Luddi1/LoRaWAN-fence-monitor/README.md

# LoRaWAN electric fence monitor

Based on STM32L071KBT and RFM95 monitors an electric fence and sends out warning if voltage too low or not present. BOM is about 20€.
