Luddi1/LoRaWAN-fence-monitor/lora_fence_monitor_hardware/Schematic.pdf

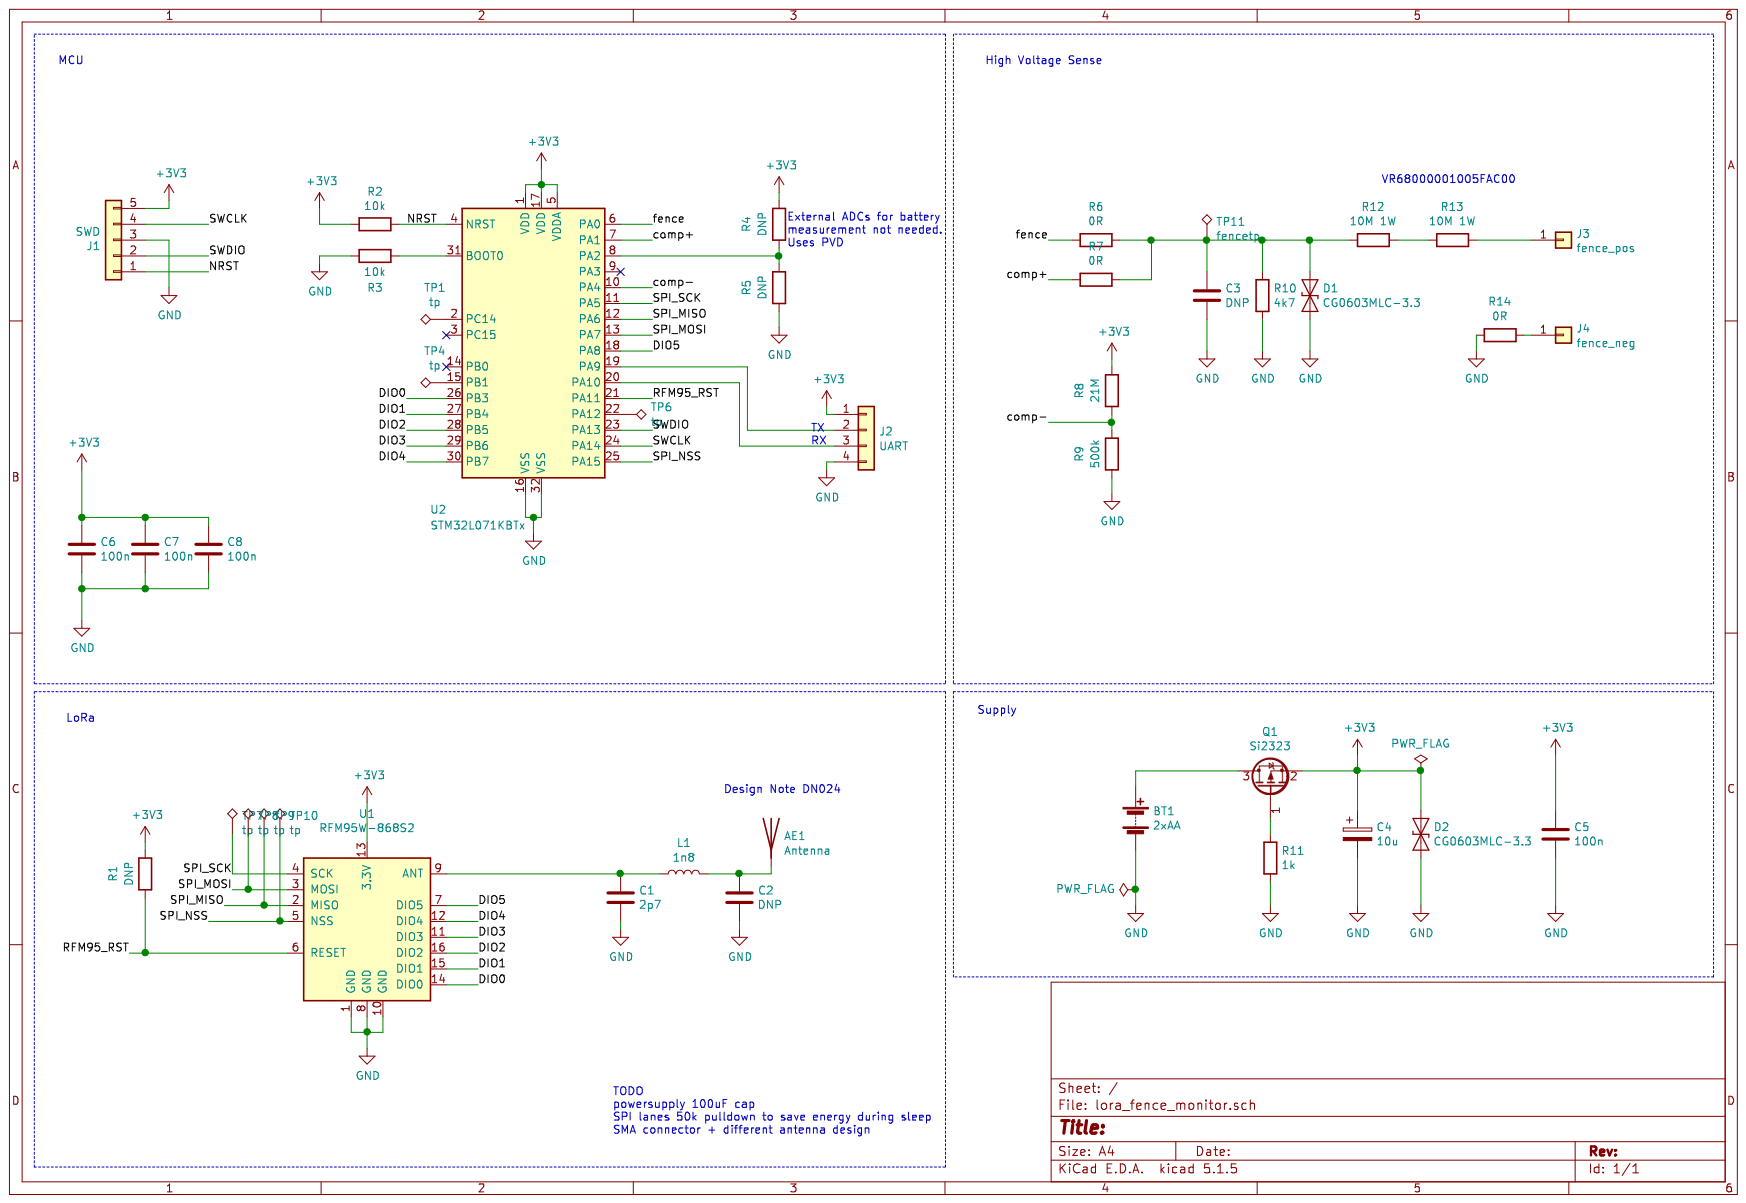
[picture p2: page 1]
