Luddi1/LoRaWAN-fence-monitor/lora_fence_monitor_hardware/lora_fence_monitor.kicad_pcb

## KiCad design lora_fence_monitor_hardware/lora_fence_monitor.kicad_pcb (2020-03-31)

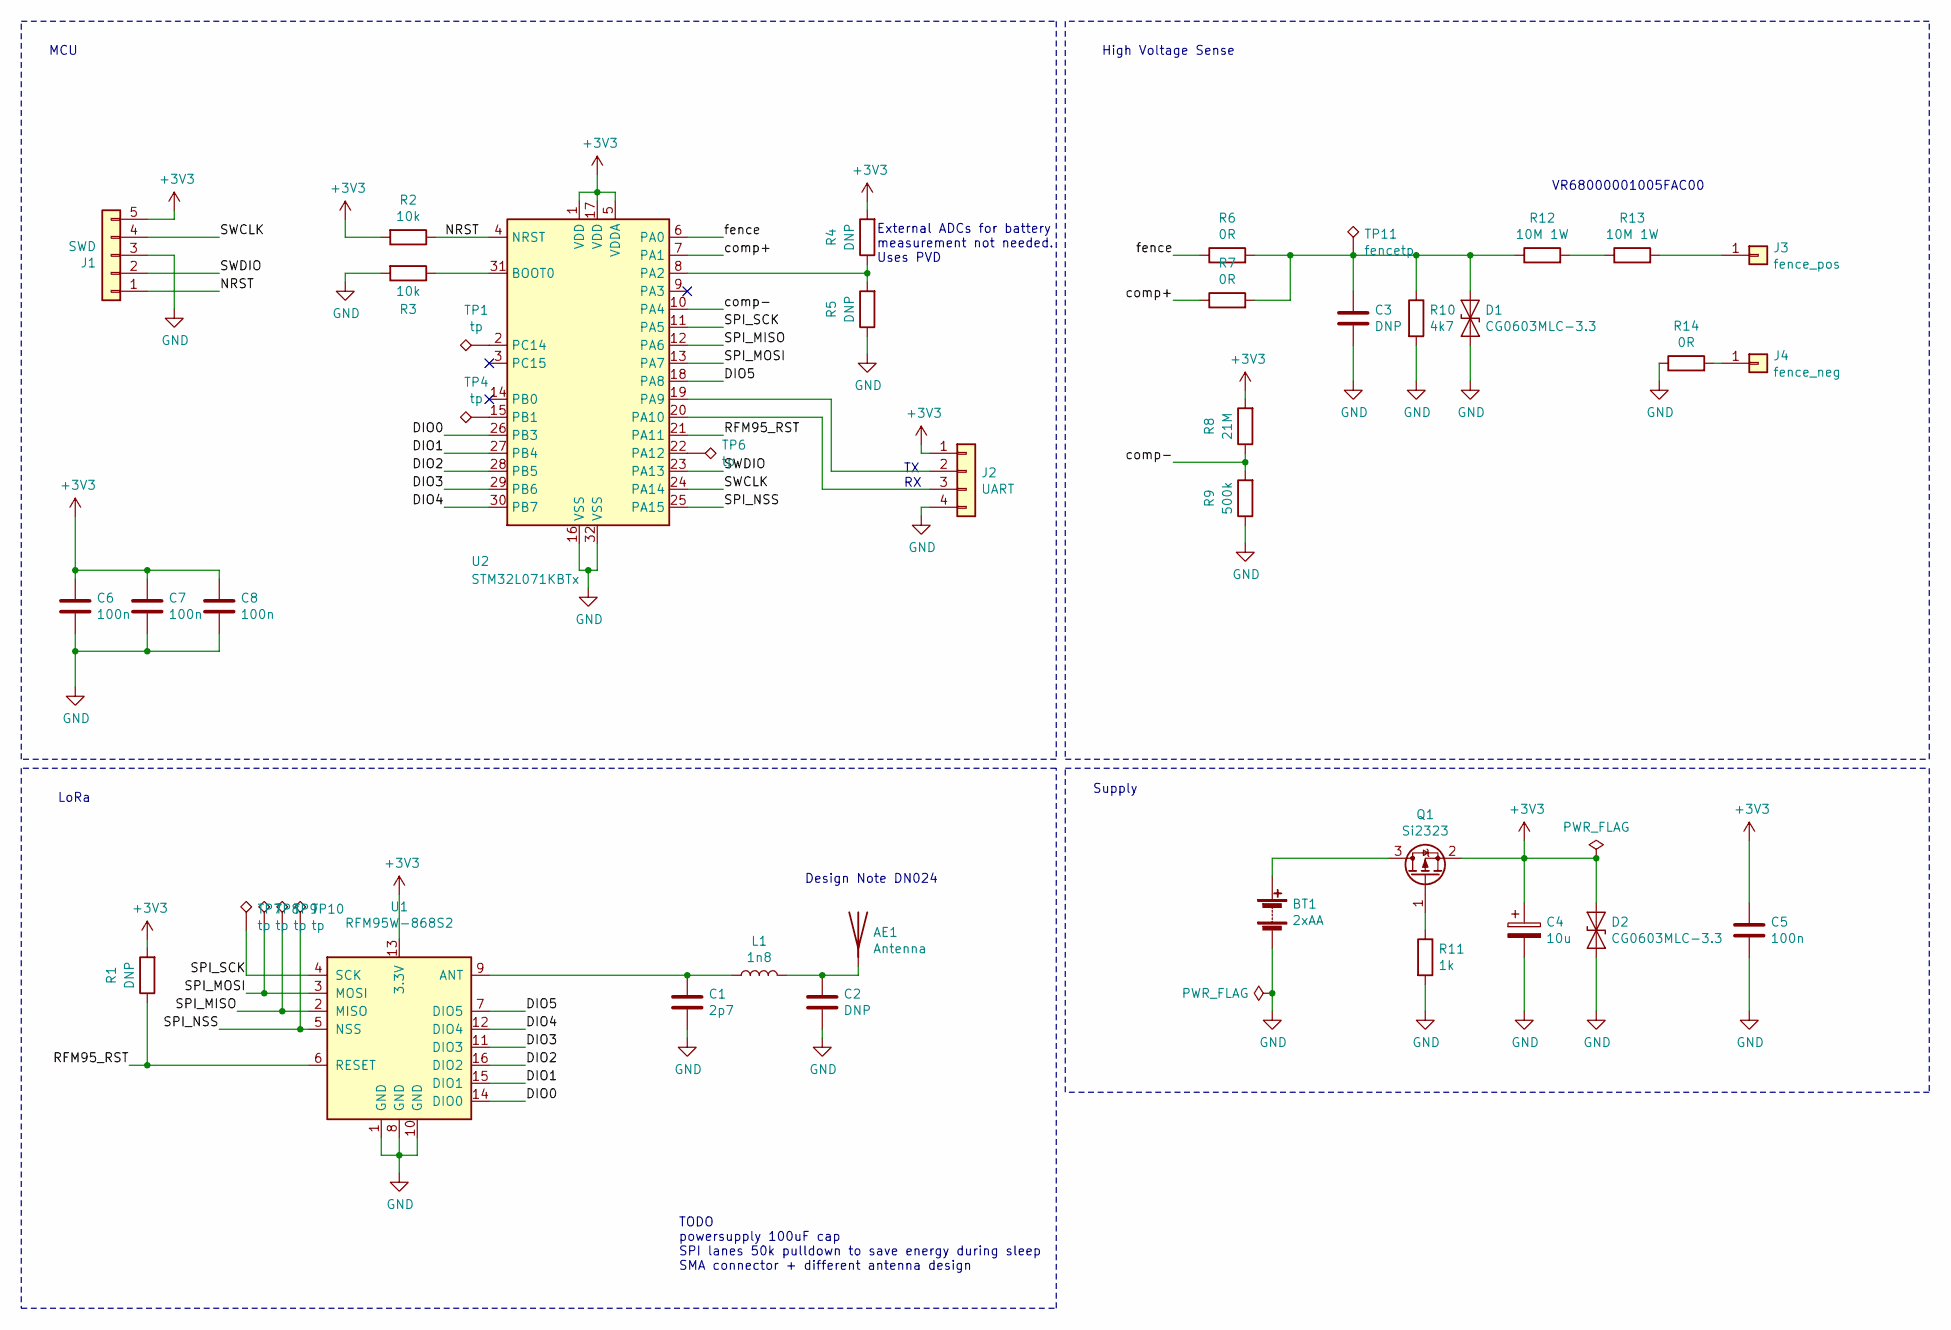
[picture p3: schematic lora_fence_monitor.sch]

Parts:
AE1: Antenna; Texas_SWRA227E_868MHz
BT1: 2xAA; BatteryHolder_Keystone_2462_2xAA
C1: 2p7; C_0402_1005Metric
C2: DNP; C_0402_1005Metric
C3: DNP; C_0805_2012Metric
C4: 10u; C_0805_2012Metric
C5, C6, C7, C8: 100n; C_0805_2012Metric
D1, D2: CG0603MLC-3.3; D_0603_1608Metric
J1: SWD; PinHeader_1x05_P2.54mm_Vertical
J2: UART; PinHeader_1x04_P2.54mm_Vertical
J3: fence_pos; PhoenixContact_MSTBVA_2,5_2-G_1x02_P5.00mm_Vertical
J4: fence_neg; PhoenixContact_MSTBVA_2,5_2-G_1x02_P5.00mm_Vertical
L1: 1n8; L_0402_1005Metric
Q1: Si2323; SOT-23
R1, R4, R5: DNP; R_0805_2012Metric
R2, R3: 10k; R_0805_2012Metric
R6, R7, R14: 0R; R_0805_2012Metric
R8: 21M; R_0805_2012Metric
R9: 500k; R_0805_2012Metric
R10: 4k7; R_0805_2012Metric
R11: 1k; R_0805_2012Metric
R12, R13: 10M 1W; R_Axial_DIN0918_L18.0mm_D9.0mm_P22.86mm_Horizontal
TP1, TP4, TP6: tp; TestPoint_THTPad_D2.5mm_Drill1.2mm
TP7, TP8, TP9, TP10: tp; PinHeader_1x01_P2.54mm_Vertical
TP11: fencetp; PinHeader_1x01_P2.54mm_Vertical
U1: RFM95W-868S2; HOPERF_RFM9XW_SMD
U2: STM32L071KBTx; LQFP-32_7x7mm_P0.8mm

Connections:
+3V3: C4.1, C5.1, C6.1, C7.1, C8.1, D2.1 (A1), J1.5, J2.1, Q1.2 (S), R1.2, R2.2, R4.2, R8.2, U1.13 (3.3V), U2.1 (VDD), U2.5 (VDDA), U2.17 (VDD)
/DIO0: U1.14 (DIO0), U2.26 (PB3)
/DIO1: U1.15 (DIO1), U2.27 (PB4)
/DIO2: U1.16 (DIO2), U2.28 (PB5)
/DIO3: U1.11 (DIO3), U2.29 (PB6)
/DIO4: U1.12 (DIO4), U2.30 (PB7)
/DIO5: U1.7 (DIO5), U2.18 (PA8)
/NRST: J1.1, R2.1, U2.4 (NRST)
/RFM95_RST: R1.1, U1.6 (RESET), U2.21 (PA11)
/SPI_MISO: TP9.1, U1.2 (MISO), U2.12 (PA6)
/SPI_MOSI: TP8.1, U1.3 (MOSI), U2.13 (PA7)
/SPI_NSS: TP10.1, U1.5 (NSS), U2.25 (PA15)
/SPI_SCK: TP7.1, U1.4 (SCK), U2.11 (PA5)
/SWCLK: J1.4, U2.24 (PA14)
/SWDIO: J1.2, U2.23 (PA13)
/comp+: R7.1, U2.7 (PA1)
/comp-: R8.1, R9.2, U2.10 (PA4)
/fence: R6.1, U2.6 (PA0)
GND: BT1.2 (-), C1.2, C2.2, C3.2, C4.2, C5.2, C6.2, C7.2, C8.2, D1.2 (A2), D2.2 (A2), J1.3, J2.4, R3.2, R5.1, R9.1, R10.2, R11.2, R14.1, U1.1 (GND), U1.8 (GND), U1.10 (GND), U2.16 (VSS), U2.32 (VSS)
unnamed: AE1.1, C2.1, L1.2
unnamed: BT1.1 (+), Q1.3 (D)
unnamed: C1.1, L1.1, U1.9 (ANT)
unnamed: C3.1, D1.1 (A1), R6.2, R7.2, R10.1, R12.1, TP11.1
unnamed: J2.2, U2.19 (PA9)
unnamed: J2.3, U2.20 (PA10)
unnamed: J3.1, R13.2
unnamed: J4.1, R14.2
unnamed: Q1.1 (G), R11.1
unnamed: R3.1, U2.31 (BOOT0)
unnamed: R4.1, R5.2, U2.8 (PA2)
unnamed: R12.2, R13.1
unnamed: TP1.1, U2.2 (PC14)
unnamed: TP4.1, U2.15 (PB1)
unnamed: TP6.1, U2.22 (PA12)

Notes on the sheet:
Design Note DN024
VR68000001005FAC00
TX RX
High Voltage Sense
MCU
LoRa
Supply
TODO powersupply 100uF cap SPI lanes 50k pulldown to save energy during sleep SMA connector + different antenna design
External ADCs for battery measurement not needed. Uses PVD

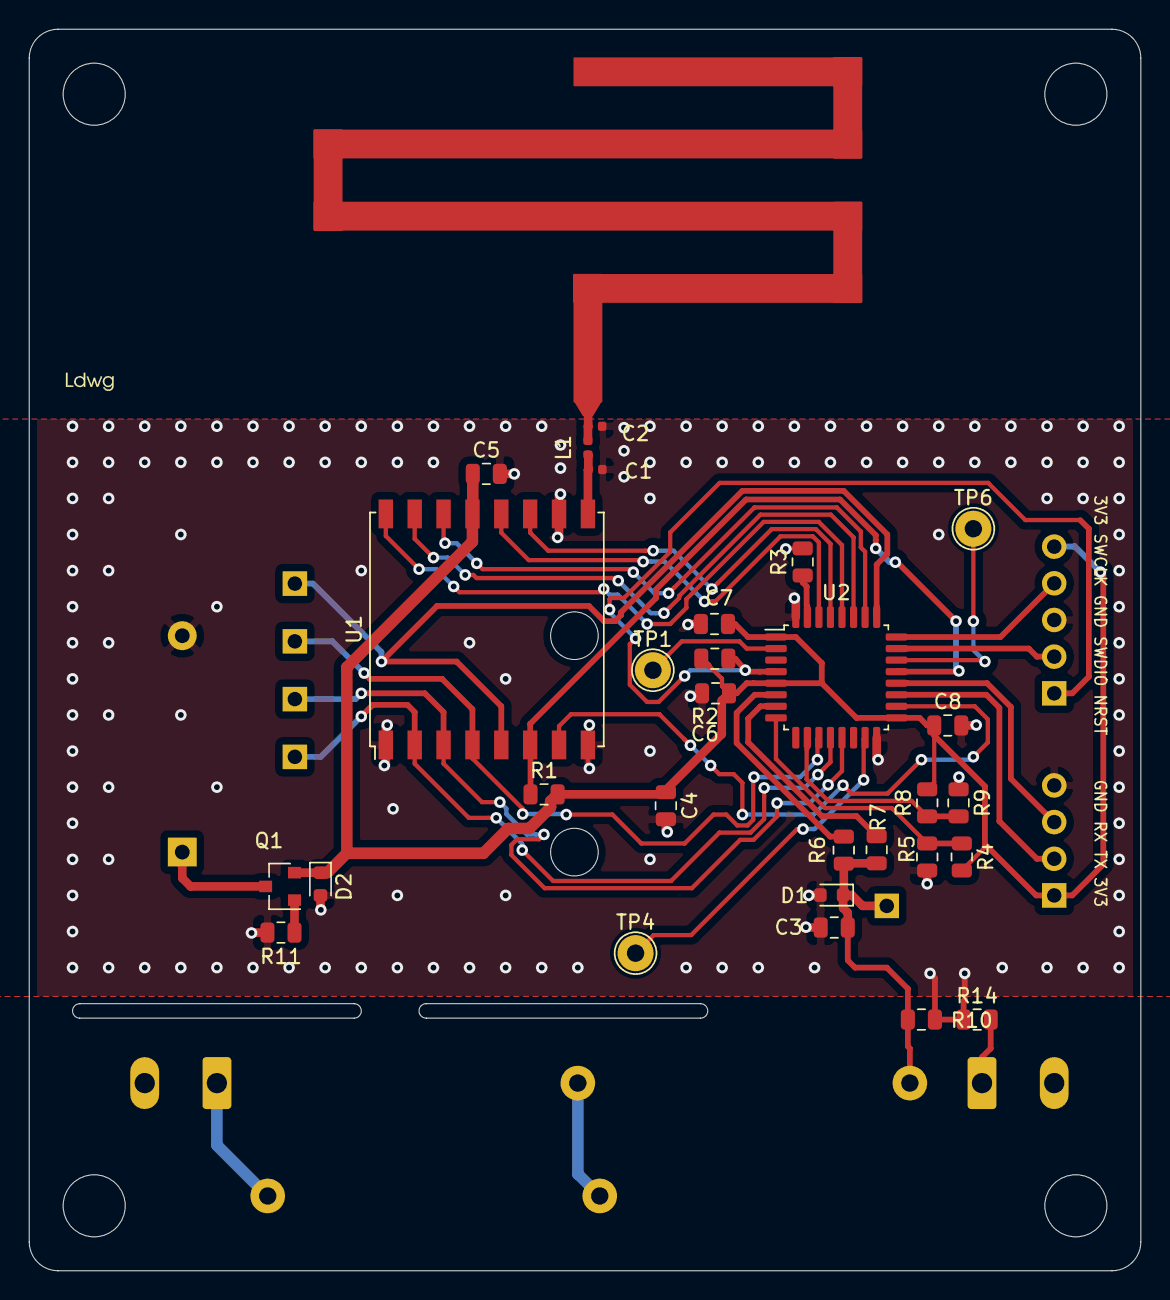
[picture p4: board lora_fence_monitor.kicad_pcb from above]

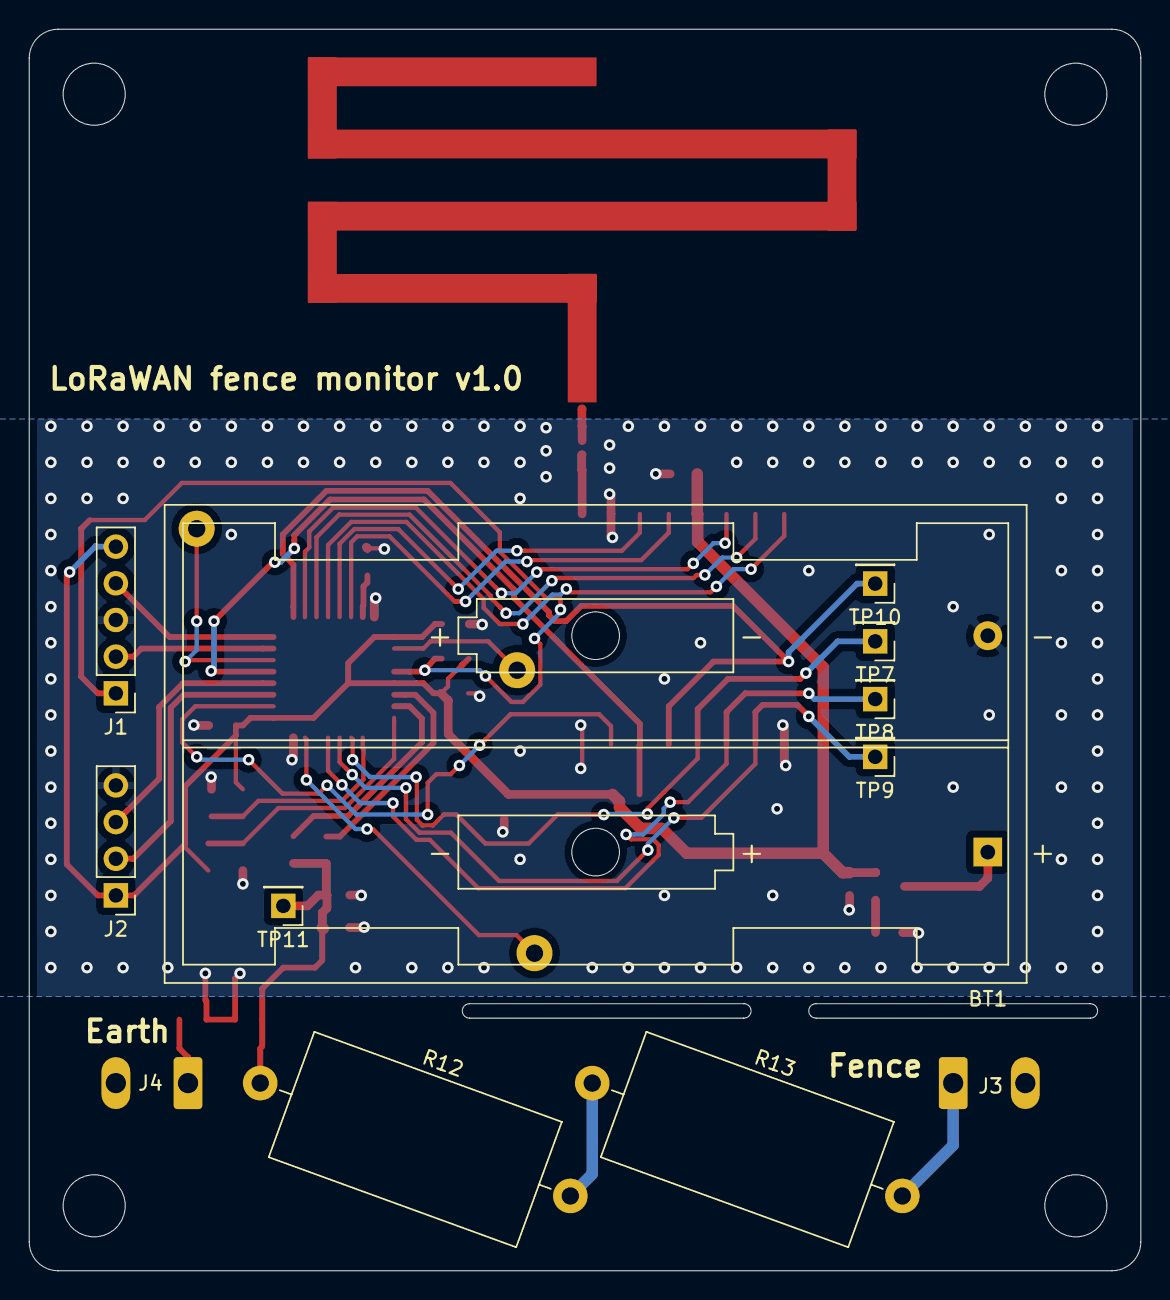
[picture p5: board lora_fence_monitor.kicad_pcb from below]

Board: 2 copper layers, 77.0 x 86.0 mm, 42 parts (12 on the bottom side), 34 nets.
