Luddi1/LoRaWAN-fence-monitor/lora_fence_monitor_firmware/lora_fence_monitor_firmware.ioc

Mcu.UserName=STM32L071KBTx
PA0.GPIO_Label=ADC_IN0_FENCE
PA0.Signal=ADC_IN0
PA1.Signal=COMP1_INP
PA10.Signal=USART1_RX
PA11.GPIO_Label=RFM95_RST
PA11.Signal=GPIO_Output
PA12.GPIO_Label=DEBUG_PA12
PA12.Signal=GPIO_Output
PA13.Signal=SYS_SWDIO
PA14.Signal=SYS_SWCLK
PA15.GPIO_Label=SPI1_NSS
PA15.Signal=GPIO_Output
PA4.Signal=COMP1_INM
PA5.Signal=SPI1_SCK
PA6.Signal=SPI1_MISO
PA7.Signal=SPI1_MOSI
PA9.Signal=USART1_TX
PB3.GPIO_Label=DIO0
PB3.Signal=GPXTI3
PB4.GPIO_Label=DIO1
PB4.Signal=GPXTI4
PB5.GPIO_Label=DIO2
PB5.Signal=GPXTI5
