Luddi1/LoRaWAN-fence-monitor/lora_fence_monitor_firmware/Inc/main.h

#define DEBUG_GET_LMIC_FROM_EEPROM  0
#define ADC_IN0_FENCE_Pin LL_GPIO_PIN_0
#define ADC_IN0_FENCE_GPIO_Port GPIOA
#define RFM95_RST_Pin LL_GPIO_PIN_11
#define RFM95_RST_GPIO_Port GPIOA
#define DEBUG_PA12_Pin LL_GPIO_PIN_12
#define DEBUG_PA12_GPIO_Port GPIOA
#define SPI1_NSS_Pin LL_GPIO_PIN_15
#define SPI1_NSS_GPIO_Port GPIOA
#define DIO0_Pin LL_GPIO_PIN_3
#define DIO0_GPIO_Port GPIOB
#define DIO0_EXTI_IRQn EXTI2_3_IRQn
#define DIO1_Pin LL_GPIO_PIN_4
#define DIO1_GPIO_Port GPIOB
#define DIO1_EXTI_IRQn EXTI4_15_IRQn
#define DIO2_Pin LL_GPIO_PIN_5
#define DIO2_GPIO_Port GPIOB
#define DIO2_EXTI_IRQn EXTI4_15_IRQn
#define NVIC_PRIORITYGROUP_0         ((uint32_t)0x00000007) /*!< 0 bit  for pre-emption priority,
#define NVIC_PRIORITYGROUP_1         ((uint32_t)0x00000006) /*!< 1 bit  for pre-emption priority,
#define NVIC_PRIORITYGROUP_2         ((uint32_t)0x00000005) /*!< 2 bits for pre-emption priority,
#define NVIC_PRIORITYGROUP_3         ((uint32_t)0x00000004) /*!< 3 bits for pre-emption priority,
#define NVIC_PRIORITYGROUP_4         ((uint32_t)0x00000003) /*!< 4 bits for pre-emption priority,
