Luddi1/LoRaWAN-fence-monitor/lora_fence_monitor_firmware/Src/usart.c

/**
  ******************************************************************************
  * File Name          : USART.c
  * Description        : This file provides code for the configuration
  *                      of the USART instances.
  ******************************************************************************
  * @attention
  *
  * <h2><center>&copy; Copyright (c) 2020 STMicroelectronics.
  * All rights reserved.</center></h2>
  *
  * This software component is licensed by ST under BSD 3-Clause license,
  * the "License"; You may not use this file except in compliance with the
  * License. You may obtain a copy of the License at:
  *                        opensource.org/licenses/BSD-3-Clause
  *
  ******************************************************************************
  */

/* Includes ------------------------------------------------------------------*/
#include "usart.h"

/* USER CODE BEGIN 0 */

#include "string.h"

#define UARTBUFFERLEN 50

static __IO uint8_t ubSend = 0;
static uint8_t aStringToSend[UARTBUFFERLEN];
static uint8_t ubSizeToSend = 0;

/* USER CODE END 0 */

/* USART1 init function */

void MX_USART1_UART_Init(void)
{
  LL_USART_InitTypeDef USART_InitStruct = {0};

  LL_GPIO_InitTypeDef GPIO_InitStruct = {0};

  /* Peripheral clock enable */
  LL_APB2_GRP1_EnableClock(LL_APB2_GRP1_PERIPH_USART1);
  
  LL_IOP_GRP1_EnableClock(LL_IOP_GRP1_PERIPH_GPIOA);
  /**USART1 GPIO Configuration  
  PA9   ------> USART1_TX
  PA10   ------> USART1_RX 
  */
  GPIO_InitStruct.Pin = LL_GPIO_PIN_9;
  GPIO_InitStruct.Mode = LL_GPIO_MODE_ALTERNATE;
  GPIO_InitStruct.Speed = LL_GPIO_SPEED_FREQ_VERY_HIGH;
  GPIO_InitStruct.OutputType = LL_GPIO_OUTPUT_PUSHPULL;
  GPIO_InitStruct.Pull = LL_GPIO_PULL_NO;
  GPIO_InitStruct.Alternate = LL_GPIO_AF_4;
  LL_GPIO_Init(GPIOA, &GPIO_InitStruct);

  GPIO_InitStruct.Pin = LL_GPIO_PIN_10;
  GPIO_InitStruct.Mode = LL_GPIO_MODE_ALTERNATE;
  GPIO_InitStruct.Speed = LL_GPIO_SPEED_FREQ_VERY_HIGH;
  GPIO_InitStruct.OutputType = LL_GPIO_OUTPUT_PUSHPULL;
  GPIO_InitStruct.Pull = LL_GPIO_PULL_NO;
  GPIO_InitStruct.Alternate = LL_GPIO_AF_4;
  LL_GPIO_Init(GPIOA, &GPIO_InitStruct);

  /* USART1 interrupt Init */
  NVIC_SetPriority(USART1_IRQn, 0);
  NVIC_EnableIRQ(USART1_IRQn);

  USART_InitStruct.BaudRate = 115200;
  USART_InitStruct.DataWidth = LL_USART_DATAWIDTH_8B;
  USART_InitStruct.StopBits = LL_USART_STOPBITS_1;
  USART_InitStruct.Parity = LL_USART_PARITY_NONE;
  USART_InitStruct.TransferDirection = LL_USART_DIRECTION_TX_RX;
  USART_InitStruct.HardwareFlowControl = LL_USART_HWCONTROL_NONE;
  USART_InitStruct.OverSampling = LL_USART_OVERSAMPLING_16;
  LL_USART_Init(USART1, &USART_InitStruct);
  LL_USART_ConfigAsyncMode(USART1);
  LL_USART_Enable(USART1);

}

/* USER CODE BEGIN 1 */

/**
  * @brief  Function to start sending
  * @param  None
  * @retval None
  */
void usartPrint(uint8_t *s, uint16_t len)
{
    // Copy data
    memcpy(aStringToSend, s, len);
    ubSizeToSend = len;
    ubSend = 0;

    /* Start USART transmission : Will initiate TXE interrupt after TDR register is empty */
    LL_USART_TransmitData8(USART1, aStringToSend[ubSend++]); 

    /* Enable TXE interrupt */
    LL_USART_EnableIT_TXE(USART1);

}

/**
  * @brief  Waits for usart to finish
  * @param  None
  * @retval None
  */
void usartFlush(void)
{
    //TODO timeout
    while (ubSend != 0);
}

/**
  * @brief  Function called for achieving next TX Byte sending
  * @param  None
  * @retval None
  */
void USART_TXEmpty_Callback(void)
{
  if(ubSend == (ubSizeToSend - 1))
  {
    /* Disable TXE interrupt */
    LL_USART_DisableIT_TXE(USART1);
    
    /* Enable TC interrupt */
    LL_USART_EnableIT_TC(USART1);
  }

  /* Fill TDR with a new char */
  LL_USART_TransmitData8(USART1, aStringToSend[ubSend++]);
}

/**
  * @brief  Function called at completion of last byte transmission
  * @param  None
  * @retval None
  */
void USART_CharTransmitComplete_Callback(void)
{
  if(ubSend == ubSizeToSend)
  {
    ubSend = 0;
    
    /* Disable TC interrupt */
    LL_USART_DisableIT_TC(USART1);
  }
}

/**
  * @brief  Function called in case of error detected in USART IT Handler
  * @param  None
  * @retval None
  */
void UsartError_Callback(void)
{

  /* Disable USARTx_IRQn */
  NVIC_DisableIRQ(USART1_IRQn);
  
}

/* USER CODE END 1 */

/************************ (C) COPYRIGHT STMicroelectronics *****END OF FILE****/
